ppsilv/A_VGA_Xilinx/Doku/P1030761.JPG

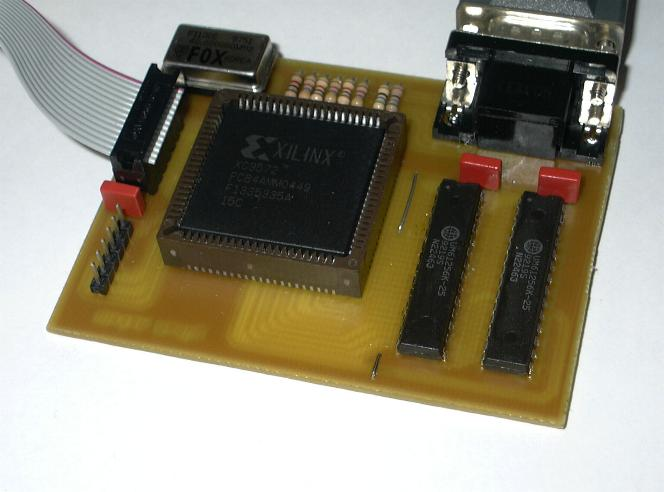
Doku/P1030761.JPG
