ppsilv/A_VGA_Xilinx/Doku/P1030762.JPG

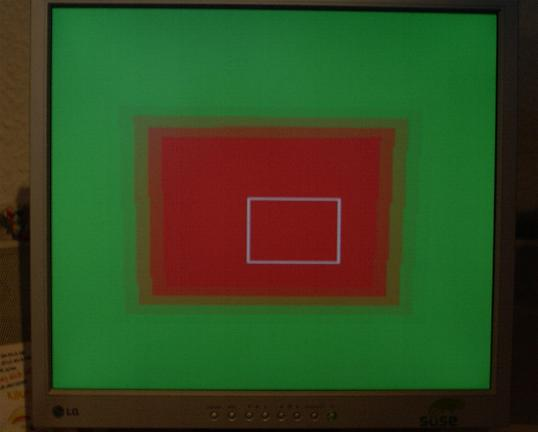
Doku/P1030762.JPG
