ppsilv/A_VGA_Xilinx/README.md

# A_VGA_Xilinx
Interface VGA using Xilinx XC95144XL
