ppsilv/A_VGA_Xilinx/Doku/P1030757.JPG

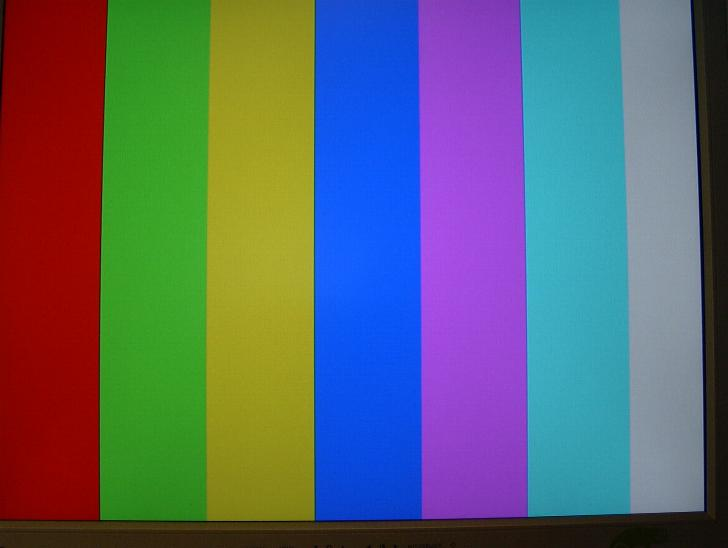
Doku/P1030757.JPG
