ppsilv/A_VGA_Xilinx/Doku/P1030765.JPG

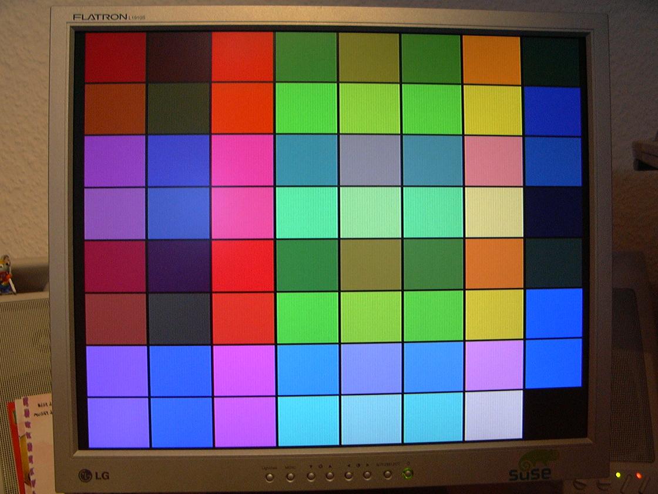
Doku/P1030765.JPG
