ppsilv/A_VGA_Xilinx/Eagle/Graka_Bottom.pdf

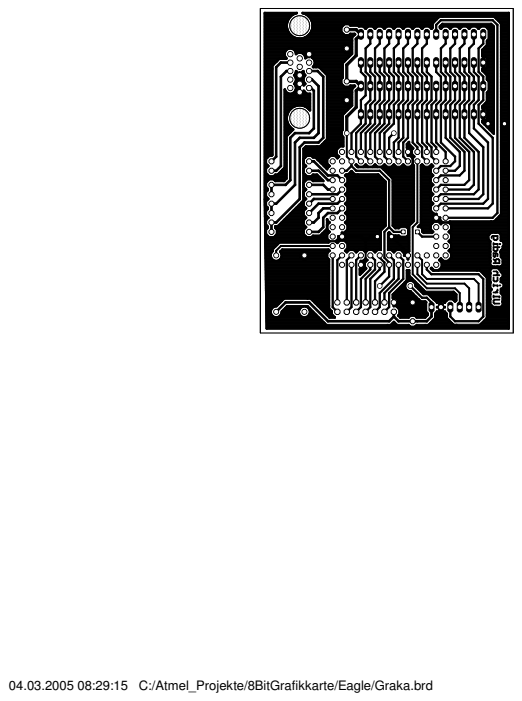
[picture p7: page 1]

04.03.2005 08:29:15 C:/Atmel_Projekte/8BitGrafikkarte/Eagle/Graka.brd
