ppsilv/A_VGA_Xilinx/Eagle/Graka_Top.pdf

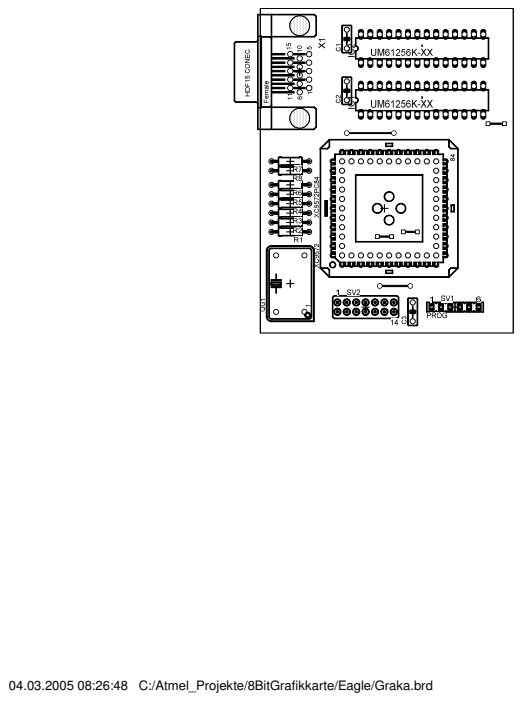
[picture p8: page 1]

04.03.2005 08:26:48 C:/Atmel_Projekte/8BitGrafikkarte/Eagle/Graka.brd
